nasheed-x/aether/hardware/aether.png

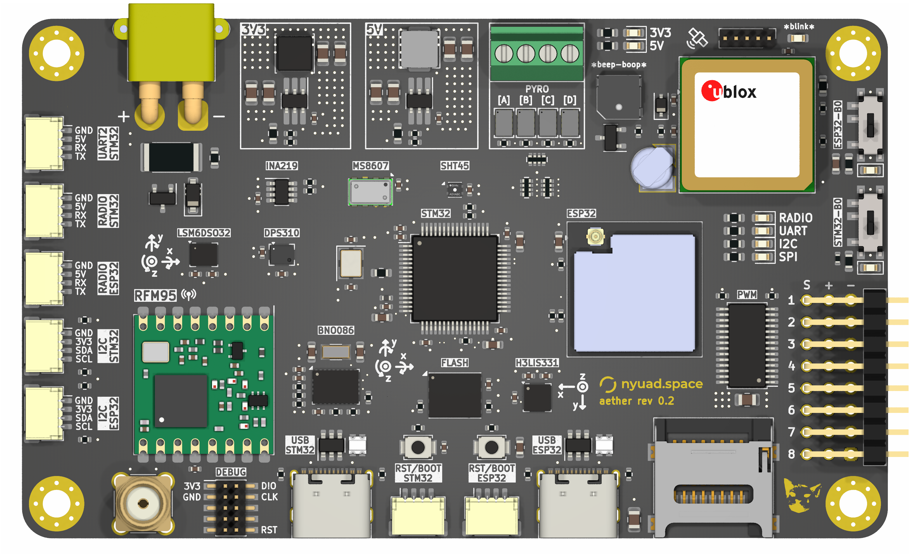
hardware/aether.png
