nasheed-x/aether/hardware/symbols/3x8 Male Pin Header Angle.STEP

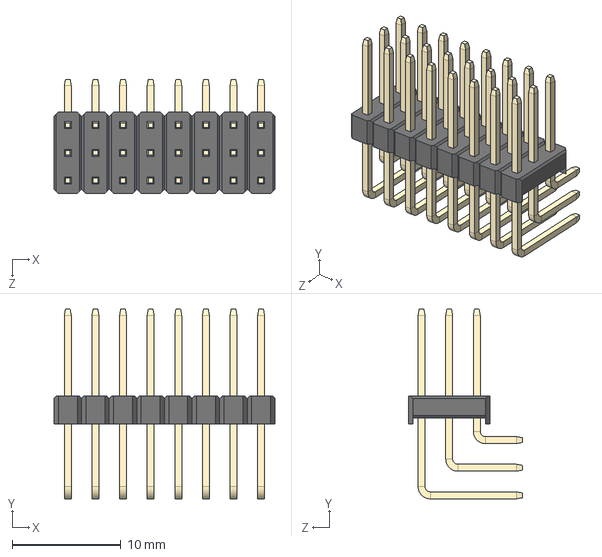
[picture p3: CAD file, 2025-07-07]
hardware/symbols/3x8 Male Pin Header Angle.STEP
20.3 x 17.4 x 10.5 mm
