nasheed-x/aether/hardware/symbols/5-1814832-1/5-1814832-1.step

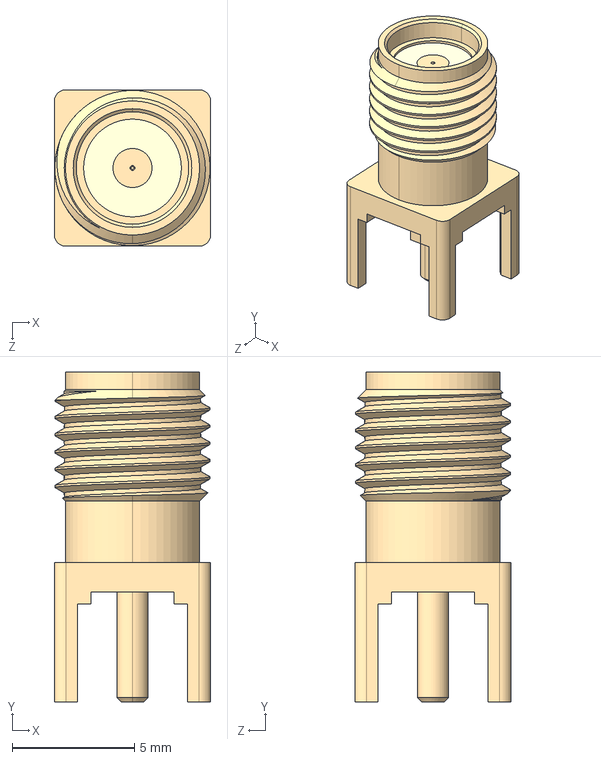
[picture p4: CAD file, 2025-07-07]
hardware/symbols/5-1814832-1/5-1814832-1.step
6.40 x 13.5 x 6.40 mm
