nasheed-x/aether/hardware/symbols/CSS-0575B-SMT/CSS-0575B-SMT.step

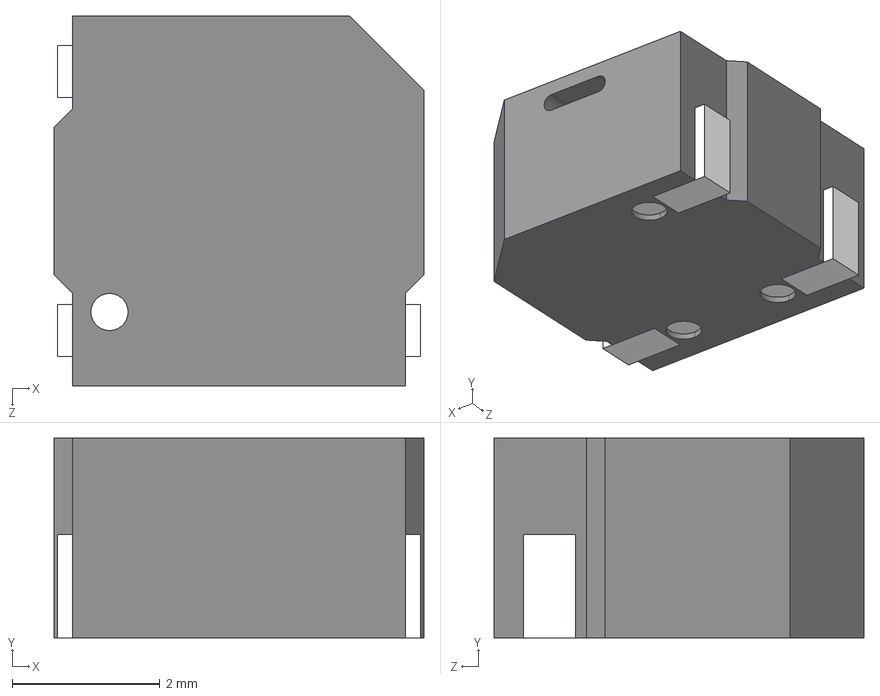
[picture p5: CAD file, 2025-07-07]
hardware/symbols/CSS-0575B-SMT/CSS-0575B-SMT.step
5.00 x 2.70 x 5.00 mm
