nasheed-x/aether/hardware/symbols/DPS310/DPS310.step

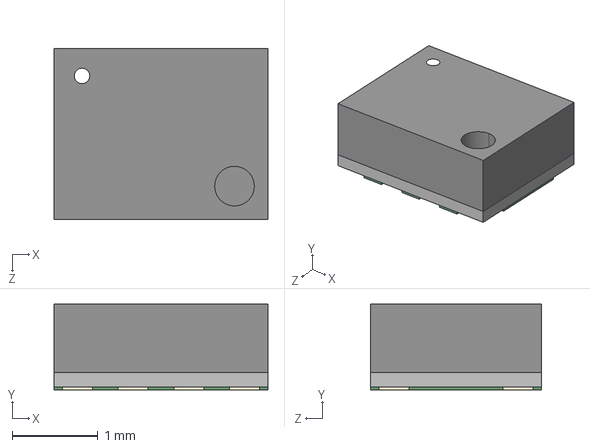
[picture p6: CAD file, 2025-07-07]
hardware/symbols/DPS310/DPS310.step
2.50 x 1.00 x 2.00 mm
