nasheed-x/aether/hardware/symbols/ESP32-S3-MINI-1U-N8/ESP32-S3-MINI-1U-N8.step

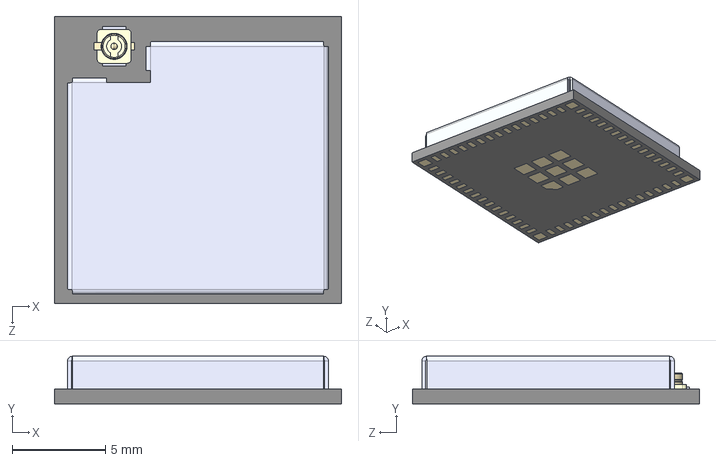
[picture p7: CAD file, 2025-07-07]
hardware/symbols/ESP32-S3-MINI-1U-N8/ESP32-S3-MINI-1U-N8.step
15.4 x 2.55 x 15.4 mm
ESP32-S3-MINI-1U-N8_ESP32-C3-MINI-1-N4
antenna jack
