nasheed-x/aether/hardware/symbols/ML414H_IV01E/ML414H_IV01E.step

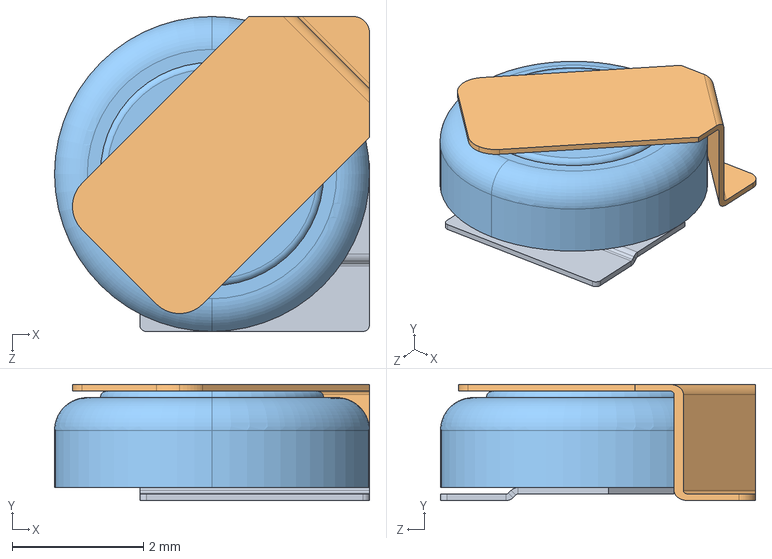
[picture p8: CAD file, 2025-07-07]
hardware/symbols/ML414H_IV01E/ML414H_IV01E.step
4.80 x 1.77 x 4.80 mm
