nasheed-x/aether/hardware/symbols/MS8607-02BA01/3D_PCB1_2025-03-28 parts - DFN-8_L5.0-W3.0-P1.25-BL-BR~DFN-8_L5.0-W3.0-P1.25-BL-BR~tLj9.step

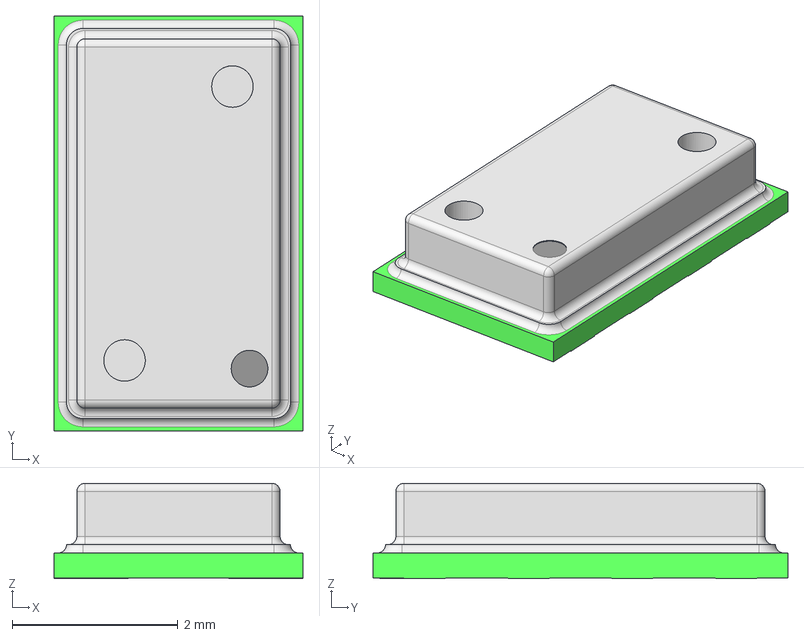
[picture p9: CAD file, 2025-07-07]
hardware/symbols/MS8607-02BA01/3D_PCB1_2025-03-28 parts - DFN-8_L5.0-W3.0-P1.25-BL-BR~DFN-8_L5.0-W3.0-P1.25-BL-BR~tLj9.step
3.00 x 5.00 x 1.15 mm
