nasheed-x/aether/hardware/symbols/SHT45-AD1B-R2/SHT45-AD1B-R2.step

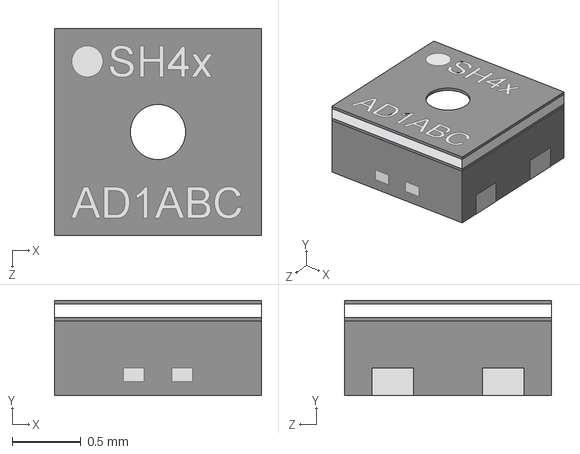
[picture p10: CAD file, 2025-07-07]
hardware/symbols/SHT45-AD1B-R2/SHT45-AD1B-R2.step
1.50 x 0.691 x 1.50 mm
