nasheed-x/aether/hardware/symbols/SI5442DU_T1_GE3/POWERPAK-CHIPFET-8_L3.0-W1.9-P0.65.step

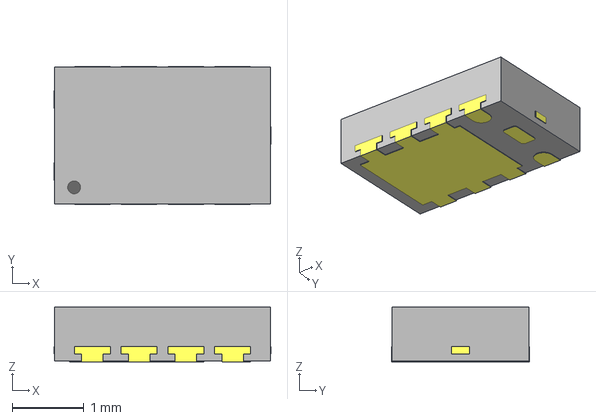
[picture p11: CAD file, 2025-07-07]
hardware/symbols/SI5442DU_T1_GE3/POWERPAK-CHIPFET-8_L3.0-W1.9-P0.65.step
3.02 x 1.92 x 0.76 mm
