nasheed-x/aether/hardware/symbols/TSW-108-08-T-T-RA/TSW-108-08-T-T-RA.step

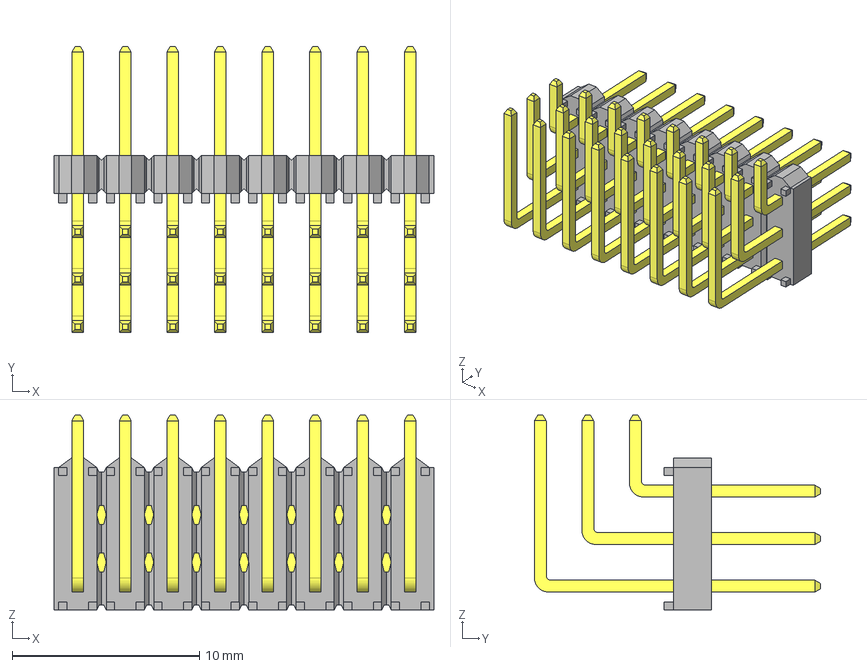
[picture p12: CAD file, 2025-07-07]
hardware/symbols/TSW-108-08-T-T-RA/TSW-108-08-T-T-RA.step
20.3 x 15.3 x 10.4 mm
TSW-108-08-T-T-RA_body
T-1S6-08-TSW-1-08-8-RA-T
