nasheed-x/aether/hardware/aether.kicad_pcb

## KiCad design hardware/aether.kicad_pcb (2025-07-12)

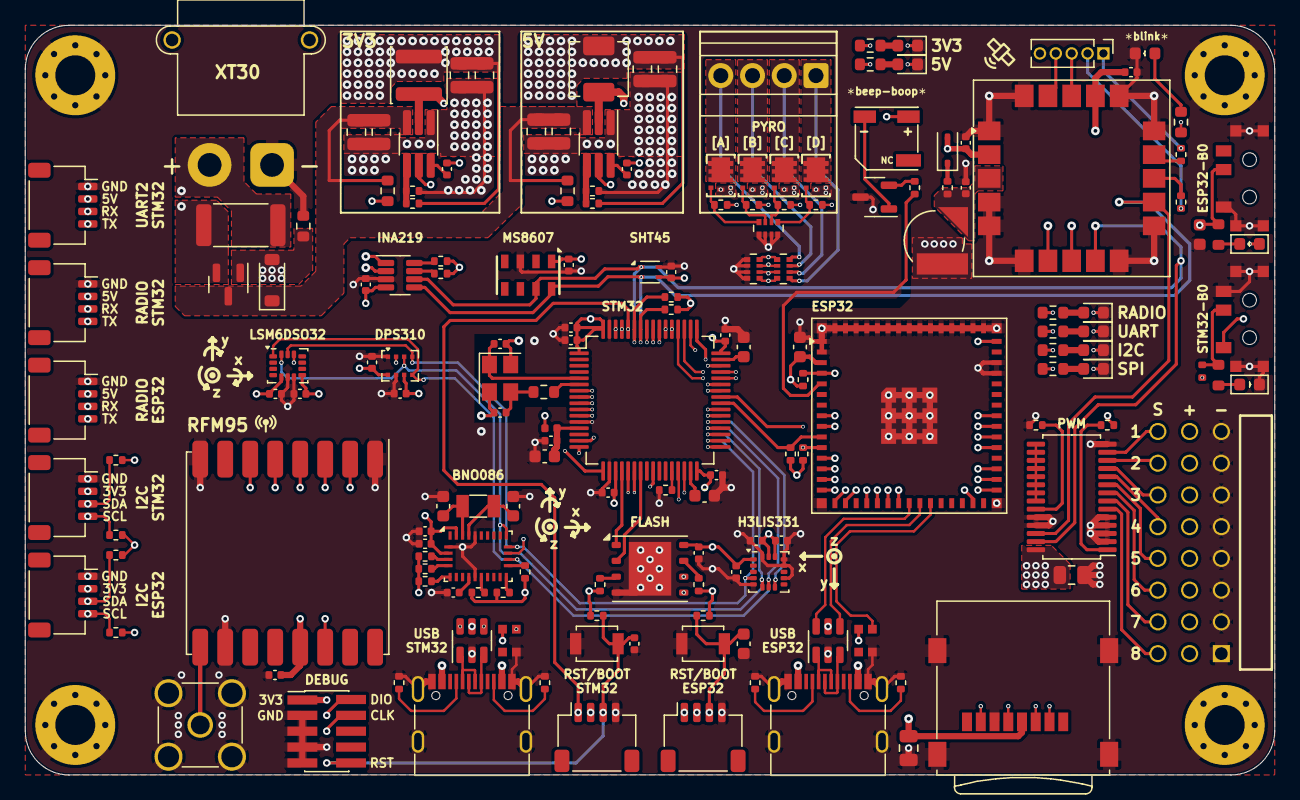
[picture p19: board hardware/aether.kicad_pcb from above]

Board: 6 copper layers, 100.0 x 60.0 mm, 173 parts (0 on the bottom side), 147 nets.

Parts:
ANT1: Antenna_Shield; SMA_Amphenol_901-144_Vertical
BT1: Battery_Cell; SEIKO_ML414H_IV01E
BUZ1: FST-5030; BUZ-SMD_FST-5030
C1, C2: 2.2uF; C_0603_1608Metric
C3, C4, C5, C6, C7, C10, C12, C16, C17, C18, C19, C20, C21, C22, C23, C24, C26, C27, C28, C30, C31, C34, C39, C42, C43, C46, C47: 100nF; C_0402_1005Metric
C8, C9: 10pF; C_0402_1005Metric
C11, C13, C14: 1uF; C_0603_1608Metric
C15: 10uF; C_0603_1608Metric
C25, C29, C32, C33, C37, C38: 10uF; C_0805_2012Metric
C35, C36, C40, C41: 22uF; C_0805_2012Metric
C44, C45: 22pF; C_0603_1608Metric
D1: PULSE_LED; LED_0603_1608Metric
D2: 0.5A/40V/420mV; D_SOD-323
D3: FUXINSEMI DSK34; D_SOD-123
D4, D5, D6, D7: LED; LED_0603_1608Metric
ESP32-S3: ESP32-S3-MINI-1U; ESP32-S2-MINI-1U
ESPBOOT0: BLUE; LED_0603_1608Metric
ESPRGB1: WS2812B-2020; LED_WS2812B-2020_PLCC4_2.0x2.0mm
ESP_B0: SS-3292S-L2-B; SW-SMD_SS-3292S-L2-B
ESP_RST1: SW_Push; SW_SPST_B3U-1000P
FB1: 600Ω; L_0402_1005Metric
G2: LOGO
GPS_IO1: Conn_01x05_Pin; PinHeader_1x05_P1.27mm_Vertical
H1, H2, H3, H4: MountingHole_Pad; MountingHole_3.2mm_M3_Pad_Via
HSE1: 25MHz; Crystal_SMD_Abracon_ABM8G-4Pin_3.2x2.5mm
I2C-ESP1, I2C-STM1: SM04B-SRSS-TB(LF)(SN); JST_SH_SM04B-SRSS-TB_1x04-1MP_P1.00mm_Horizontal
INA219: INA219AxDCN; SOT-23-8
L1: 4.7uH; L_Changjiang_FXL0420
L2: 3.3uH; L_Changjiang_FNR4030S
LED1, LED2: R; LED_0603_1608Metric
PCA9685: PCA9685PW; TSSOP-28_4.4x9.7mm_P0.65mm
PWM1: 24-Pin 8x3 Male Header - Angle; SAMTEC_TSW-108-08-T-T-RA
PYRO1: Screw_Terminal_01x04; TerminalBlock_Xinya_XY308-2.54-4P_1x04_P2.54mm_Horizontal
Q1: S8050_C2146; SOT-23-3
Q6: AO3401A; SOT-23
R1, R5, R13, R25, R26, R27, R28, R29, R30, R31, R32, R37, R40, R42, R43, R58, R59, R60, R61: 10k; R_0402_1005Metric
R2: 1k; R_0402_1005Metric
R3: 620; R_0603_1608Metric
R4: 2.2K; R_0603_1608Metric
R6, R7, R16, R19, R20, R55: 5.1k; R_0402_1005Metric
R8, R9, R10, R11: 330; R_0402_1005Metric
R12, R23, R45, R46, R47, R48, R49, R50: 2.2k; R_0603_1608Metric
R14, R15, R33, R34, R56, R57: 4.7k; R_0402_1005Metric
R21, R22: 470; R_0402_1005Metric
R24: 3.3k; R_0402_1005Metric
R35, R38, R41: 100k; R_0603_1608Metric
R36: 54.9k; R_0402_1005Metric
R39: 33.2k; R_0402_1005Metric
R44: 0.01; R_2512_6332Metric
RFM95: RFM95W-915S2; HOPERF_RFM9XW_SMD
RN1: 10k; R_Array_Convex_4x0402
RN2: 47k; R_Array_Convex_4x0402
RN3: 270k; R_Array_Convex_4x0402
RST-BOOT-ESP32: SM04B-SRSS-TB(LF)(SN); JST_SH_SM04B-SRSS-TB_1x04-1MP_P1.00mm_Horizontal
RST-BOOT-STM32: SM04B-SRSS-TB(LF)(SN); JST_SH_SM04B-SRSS-TB_1x04-1MP_P1.00mm_Horizontal
SAM-M10Q1: SAM-M10Q-00B; ublox_SAM-M8Q
SD1: Micro_SD_Card; microSD_HC_Wuerth_693072010801
STM32F4: STM32F405RGTx; LQFP-64_10x10mm_P0.5mm
STMBOOT0: BLUE; LED_0603_1608Metric
STMRGB1: WS2812B-2020; LED_WS2812B-2020_PLCC4_2.0x2.0mm
STM_B0: SS-3292S-L2-B; SW-SMD_SS-3292S-L2-B
STM_RST1: SW_Push; SW_SPST_B3U-1000P
SWD1: Conn_02x05_Odd_Even; PinHeader_2x05_P1.27mm_Vertical_SMD
U1, U2: USBLC6-2SC6; SOT-23-6
U3, U7, U12, U14: SI5448DU-T1-GE3; SON_8DU-T1-GE3_VIS
U4: DPS310; XDCR_DPS310
U5: H3LIS331DL; LGA-16_3x3mm_P0.5mm_LayoutBorder3x5y
U6: LSM6DSO32TR; LGA-14_3x2.5mm_P0.5mm_LayoutBorder3x4y
U8: MS860702BA01-50; MS8607-02BA01
U9: SHT45-AD1B-R2; Sensirion_DFN-4_1.5x1.5mm_P0.8mm_SHT4x_NoCentralPad
U10, U11: TPS562201DDCR; TSOT-23-6_HandSoldering
U13: BNO086; LGA-28_5.2x3.8mm_P0.5mm
U15: W25Q128JVP; WSON-8-1EP_6x5mm_P1.27mm_EP3.4x4.3mm
UART1-RFD-ESP1, UART1-RFD-STM1, UART2-STM1: SM04B-SRSS-TB(LF)(SN); JST_SH_SM04B-SRSS-TB_1x04-1MP_P1.00mm_Horizontal
USB_ESP32: USB_C_Receptacle_USB2.0; USB_C_Receptacle_G-Switch_GT-USB-7010ASV
USB_STM32: USB_C_Receptacle_USB2.0; USB_C_Receptacle_G-Switch_GT-USB-7010ASV
XT30: XT30PW-M; AMASS_XT30PW-M_1x02_P2.50mm_Horizontal
Y1: 32.768kHz; Crystal_SMD_3215-2Pin_3.2x1.5mm

Connections:
3.3V: BUZ1.1 (+), C3.1, C4.1, C5.1, C6.1, C7.1, C15.1, C16.1, C17.1, C18.1, C19.1, C20.1, C21.1, C22.1, C24.1, C25.1, C26.1, C27.1, C28.1, C29.1, C30.1, C31.1, C40.1, C41.1, C42.1, C46.1, C47.1, D2.2 (A), ESP32-S3.3 (3V3), ESPBOOT0.2 (A), ESPRGB1.4 (VDD), FB1.2, I2C-ESP1.2, I2C-STM1.2, INA219.4 (VS), L2.2, PCA9685.28 (VDD), R13.2, R14.2, R15.2, R16.2, R25.1, R26.1, R28.2, R29.2, R30.2, R31.2, R32.2, R33.2, R34.2, R39.1, R42.2, R43.2, R46.1, R55.2, R56.2, R57.2, R58.1, R59.1, R60.1, R61.2, RFM95.13 (3.3V), RST-BOOT-ESP32.2, RST-BOOT-STM32.2, SAM-M10Q1.2 (V_IO), SAM-M10Q1.17 (VCC), SD1.4 (VDD), STM32F4.1 (VBAT), STM32F4.19 (VDD), STM32F4.32 (VDD), STM32F4.48 (VDD), STM32F4.64 (VDD), STMRGB1.4 (VDD), STM_B0.1, SWD1.1, U4.6 (VDDIO), U4.8 (VDD), U5.1 (VDD_IO), U5.14 (VDD), U5.15 (VDD), U6.5 (VDDIO), U6.8 (VDD), U8.1 (VDD), U9.3 (VDD), U13.3 (VDD), U13.28 (VDDIO), U15.8 (VCC)
5V: C35.1, C36.1, L1.2, PWM1.02, PWM1.05, PWM1.08, PWM1.11, PWM1.14, PWM1.17, PWM1.20, PWM1.23, R36.1, R45.1, UART1-RFD-ESP1.2, UART1-RFD-STM1.2, UART2-STM1.2
BNO086_CS: STM32F4.39 (PC8), U13.18 (~H_CS)
BNO086_MISO: SD1.3 (CMD), STM32F4.35 (PB14), U4.3 (SDI), U5.6 (SDA/SDI/SDO), U6.14 (SDA), U13.20 (H_SDA/H_MISO/TX)
BNO086_MOSI: SD1.7 (DAT0), STM32F4.36 (PB15), U4.5 (SDO), U5.7 (SDO/SA0), U6.1 (SDO/SA0), U13.17 (SA0/H_MOSI)
BNO086_RST: R61.1, U13.11 (~RST)
BNO086_SCK: SD1.5 (CLK), STM32F4.34 (PB13), U4.4 (SCK), U5.4 (SCL/SPC), U6.13 (SCL), U13.19 (H_SCL/SCK/RX)
BUZZ_IN: ESP32-S3.5 (IO1), R2.2
CROSS_I2C: ESP32-S3.36 (IO40), R49.2
CROSS_SPI: ESP32-S3.35 (IO39), R48.2
CROSS_UART: ESP32-S3.37 (IO41), R50.2
DPS310_CSB: STM32F4.33 (PB12), U4.2 (~CSB)
ESP32-EN: C14.1, ESP32-S3.45 (EN), ESP_RST1.2, R16.1, RST-BOOT-ESP32.3
ESP32-GPIO0: C13.1, ESP32-S3.4 (IO0), ESP_B0.2, R12.1, R13.1, RST-BOOT-ESP32.1
ESP32-I2C1_SCL: ESP32-S3.9 (IO5), I2C-ESP1.4, R32.1
ESP32-I2C1_SDA: ESP32-S3.8 (IO4), I2C-ESP1.3, R31.1
ESP32-I2C2_SCL: ESP32-S3.11 (IO7), R15.1, STM32F4.41 (PA8)
ESP32-I2C2_SDA: ESP32-S3.10 (IO6), R14.1, STM32F4.40 (PC9)
ESP32-RGB_IN: ESP32-S3.25 (IO21), ESPRGB1.3 (DIN)
ESP32-RX1: ESP32-S3.22 (IO18), UART1-RFD-ESP1.3
ESP32-RX2: ESP32-S3.20 (IO16), STM32F4.51 (PC10)
ESP32-SPI1_CS0: ESP32-S3.14 (IO10), RFM95.5 (NSS)
ESP32-SPI1_MISO: ESP32-S3.17 (IO13), RFM95.2 (MISO)
ESP32-SPI1_MOSI: ESP32-S3.15 (IO11), RFM95.3 (MOSI)
ESP32-SPI1_SCK: ESP32-S3.16 (IO12), RFM95.4 (SCK)
ESP32-SPI2_CS0: ESP32-S3.29 (IO34), STM32F4.50 (PA15)
ESP32-SPI2_MISO: ESP32-S3.33 (IO37), STM32F4.56 (PB4)
ESP32-SPI2_MOSI: ESP32-S3.31 (IO35), STM32F4.57 (PB5)
ESP32-SPI2_SCK: ESP32-S3.32 (IO36), STM32F4.55 (PB3)
ESP32-TX1: ESP32-S3.21 (IO17), UART1-RFD-ESP1.4
ESP32-TX2: ESP32-S3.19 (IO15), STM32F4.52 (PC11)
ESP32-USB_D+: ESP32-S3.24 (USB_D+), U2.4 (I/O2)
ESP32-USB_D-: ESP32-S3.23 (USB_D-), U2.6 (I/O1)
F405_VDDA: C10.1, C11.1, FB1.1, STM32F4.13 (VDDA)
FLASH_CLK: STM32F4.21 (PA5), U15.6 (CLK)
FLASH_CS: STM32F4.20 (PA4), U15.1 (~CS)
FLASH_HOLD: R26.2, U15.7 (~HOLD/~RESET/IO_{3})
FLASH_SDI: STM32F4.22 (PA6), U15.5 (DI/IO_{0})
FLASH_SDO: STM32F4.23 (PA7), U15.2 (DO/IO_{1})
FLASH_WP: R25.2, U15.3 (~WP/IO_{2})
GND: ANT1.2 (Shield), BT1.2 (-), C1.2, C2.2, C3.2, C4.2, C5.2, C6.2, C7.2, C8.1, C9.2, C10.2, C11.2, C12.2, C13.2, C14.2, C15.2, C16.2, C17.2, C18.2, C19.2, C20.2, C21.2, C22.2, C23.2, C24.2, C25.2, C26.2, C27.2, C28.2, C29.2, C30.2, C31.2, C32.2, C33.2, C35.2, C36.2, C37.2, C38.2, C40.2, C41.2, C42.2, C43.2, C44.2, C45.2, C46.2, C47.2, D1.1 (K), D4.1 (K), D5.1 (K), D6.1 (K), D7.1 (K), ESP32-S3.1 (GND), ESP32-S3.2 (GND), ESP32-S3.42 (GND), ESP32-S3.43 (GND), ESP32-S3.46 (GND), ESP32-S3.47 (GND), ESP32-S3.48 (GND), ESP32-S3.49 (GND), ESP32-S3.50 (GND), ESP32-S3.51 (GND), ESP32-S3.52 (GND), ESP32-S3.53 (GND), ESP32-S3.54 (GND), ESP32-S3.55 (GND), ESP32-S3.56 (GND), ESP32-S3.57 (GND), ESP32-S3.58 (GND), ESP32-S3.59 (GND), ESP32-S3.60 (GND), ESP32-S3.61 (GND), ESP32-S3.62 (GND), ESP32-S3.63 (GND), ESP32-S3.64 (GND), ESP32-S3.65 (GND), ESPRGB1.2 (VSS), ESP_B0.1, ESP_B0.EH, ESP_RST1.1, H1.1, H2.1, H3.1, H4.1, HSE1.2, HSE1.4, I2C-ESP1.1, I2C-STM1.1, INA219.3 (GND), LED1.1 (K), LED2.1 (K), PCA9685.2 (A1), PCA9685.3 (A2), PCA9685.4 (A3), PCA9685.5 (A4), PCA9685.14 (VSS), PCA9685.24 (A5), PCA9685.25 (EXTCLK), PWM1.01, PWM1.04, PWM1.07, PWM1.10, PWM1.13, PWM1.16, PWM1.19, PWM1.22, Q1.3 (E), R1.1, R6.1, R7.2, R19.1, R20.2, R27.2, R37.2, R40.2, R41.2, RFM95.1 (GND), RFM95.8 (GND), RFM95.10 (GND), RN1.5 (R4.2), RN1.6 (R3.2), RN1.7 (R2.2), RN1.8 (R1.2), RN2.1 (R1.1), RN2.2 (R2.1), RN2.3 (R3.1), RN2.4 (R4.1), RST-BOOT-ESP32.4, RST-BOOT-STM32.4, SAM-M10Q1.1 (GND), SAM-M10Q1.4 (GND), SAM-M10Q1.5 (GND), SAM-M10Q1.6 (GND), SAM-M10Q1.10 (GND), SAM-M10Q1.11 (GND), SAM-M10Q1.15 (GND), SAM-M10Q1.16 (GND), SAM-M10Q1.20 (GND), SD1.6 (VSS), SD1.9 (SHIELD), STM32F4.12 (VSSA), STM32F4.18 (VSS), STM32F4.63 (VSS), STMBOOT0.1 (K), STMRGB1.2 (VSS), STM_B0.3, STM_B0.EH, STM_RST1.1, SWD1.3, SWD1.5, SWD1.7, SWD1.9, U1.2 (GND), U2.2 (GND), U3.5 (S), U3.9 (S), U4.1 (GND), U4.7 (GND), U5.5 (GND), U5.10 (GND), U5.12 (GND), U5.13 (GND), U5.16 (GND), U6.6 (GND), U6.7 (GND), U7.5 (S), U7.9 (S), U8.3 (GND), U9.4 (VSS), U10.1 (GND), U11.1 (GND), U12.5 (S), U12.9 (S), U13.2 (GND), U13.10 (CLKSEL0), U13.25 (GNDIO), U14.5 (S), U14.9 (S), U15.4 (GND), U15.9 (EP), UART1-RFD-ESP1.1, UART1-RFD-STM1.1, UART2-STM1.1, USB_ESP32.A1 (GND), USB_ESP32.A12 (GND), USB_ESP32.B1 (GND), USB_ESP32.B12 (GND), USB_ESP32.S1 (SHIELD), USB_STM32.A1 (GND), USB_STM32.A12 (GND), USB_STM32.B1 (GND), USB_STM32.B12 (GND), USB_STM32.S1 (SHIELD), XT30.1 (N)
GPS_INT: GPS_IO1.4, SAM-M10Q1.19 (EXTINT)
GPS_RST: GPS_IO1.3, SAM-M10Q1.18 (~RESET)
GPS_RX: GPS_IO1.1, R22.2
GPS_SAFE: GPS_IO1.5, SAM-M10Q1.8 (~SAFEBOOT)
GPS_SCL: INA219.5 (SCL), PCA9685.26 (SCL), R34.1, SAM-M10Q1.12 (SCL), STM32F4.58 (PB6), U8.8 (SCL), U9.2 (SCL)
GPS_SDA: INA219.6 (SDA), PCA9685.27 (SDA), R33.1, SAM-M10Q1.9 (SDA), STM32F4.59 (PB7), U8.7 (SDA), U9.1 (SDA)
GPS_TX: GPS_IO1.2, R21.1
GPS_VBCKP: BT1.1 (+), C23.1, R24.1, SAM-M10Q1.3 (V_BCKP)
H3LIS331DL_CS: STM32F4.37 (PC6), U5.8 (CS)
INA219_IN+: INA219.1 (IN+), R44.1, XT30.2
INA219_IN-: INA219.2 (IN-), Q6.2 (D), R44.2
LSM6DSO32TR_CS: STM32F4.25 (PC5), U6.12 (CS)
unnamed: C9.1, HSE1.3, R3.2
unnamed: D1.2 (A), R23.1
unnamed: D2.1 (K), R24.2
unnamed: D4.2 (A), R47.1
unnamed: D5.2 (A), R48.1
unnamed: D6.2 (A), R49.1
unnamed: D7.2 (A), R50.1
unnamed: ESPBOOT0.1 (K), R12.2
unnamed: INA219.7 (A0), R43.1
unnamed: INA219.8 (A1), R42.1
unnamed: LED1.2 (A), R45.2
unnamed: LED2.2 (A), R46.2
unnamed: PCA9685.1 (A0), R28.1
unnamed: PCA9685.23 (~OE), R27.1
unnamed: Q1.2 (B), R2.1
unnamed: BUZ1.2, Q1.1 (C)
unnamed: R4.2, R5.2, STM_B0.2
unnamed: R11.1, RN1.1 (R1.1), U3.4 (G)
unnamed: R10.1, RN1.2 (R2.1), U7.4 (G)
unnamed: R9.1, RN1.3 (R3.1), U12.4 (G)
unnamed: R8.1, RN1.4 (R4.1), U14.4 (G)
unnamed: R22.1, SAM-M10Q1.14 (RXD)
unnamed: R21.2, SAM-M10Q1.13 (TXD)
unnamed: R1.2, STM32F4.28 (PB2)
unnamed: C1.1, STM32F4.31 (VCAP_1)
unnamed: C2.1, STM32F4.47 (VCAP_2)
unnamed: R4.1, STMBOOT0.2 (A)
unnamed: R35.2, U10.5 (EN)
unnamed: C34.2, L1.1, U10.2 (SW)
unnamed: C34.1, U10.6 (VBST)
unnamed: R36.2, R37.1, U10.4 (VFB)
unnamed: R38.2, U11.5 (EN)
unnamed: C39.2, L2.1, U11.2 (SW)
unnamed: C39.1, U11.6 (VBST)
unnamed: R39.2, R40.1, U11.4 (VFB)
unnamed: C43.1, U13.9 (CAP)
unnamed: R56.1, U13.15 (ENV_SCL)
unnamed: R57.1, U13.16 (ENV_SDA)
unnamed: R59.2, U13.6 (PS0/WAKE)
unnamed: R58.2, U13.5 (PS1)
unnamed: C44.1, U13.27 (XIN32), Y1.2
unnamed: C45.1, U13.26 (XOUT32/CLKSEL1), Y1.1
unnamed: R60.2, U13.4 (~BOOT)
unnamed: R19.2, USB_ESP32.A5 (CC1)
unnamed: R20.1, USB_ESP32.B5 (CC2)
unnamed: R6.2, USB_STM32.A5 (CC1)
unnamed: R7.1, USB_STM32.B5 (CC2)
PULSE: R23.2, SAM-M10Q1.7 (TIMEPULSE)
PWM0: PCA9685.13 (LED7), PWM1.24
PWM1: PCA9685.12 (LED6), PWM1.21
PWM2: PCA9685.11 (LED5), PWM1.18
PWM3: PCA9685.10 (LED4), PWM1.15
PWM4: PCA9685.9 (LED3), PWM1.12
PWM5: PCA9685.8 (LED2), PWM1.09
PWM6: PCA9685.7 (LED1), PWM1.06
PWM7: PCA9685.6 (LED0), PWM1.03
PYRO-TERM_A: PYRO1.4, RN3.8 (R1.2), U14.1 (D)
PYRO-TERM_B: PYRO1.3, RN3.7 (R2.2), U12.1 (D)
PYRO-TERM_C: PYRO1.2, RN3.6 (R3.2), U7.1 (D)
PYRO-TERM_D: PYRO1.1, RN3.5 (R4.2), U3.1 (D)
PYRO_A: R8.2, STM32F4.62 (PB9)
PYRO_B: R9.2, STM32F4.61 (PB8)
PYRO_C: R10.2, STM32F4.54 (PD2)
PYRO_D: R11.2, STM32F4.53 (PC12)
RFD_900: ESP32-S3.38 (IO42), R47.2
RFM95W_ANT: ANT1.1 (A), RFM95.9 (ANT)
RFM95W_DI0: ESP32-S3.13 (IO9), RFM95.14 (DIO0)
RFM95W_RST: ESP32-S3.12 (IO8), RFM95.6 (RESET)
SD_CS: SD1.2 (DAT3/CD), STM32F4.38 (PC7)
STM32-BOOT0: R5.1, RST-BOOT-STM32.1, STM32F4.60 (BOOT0)
STM32-HSE_IN: C8.2, HSE1.1, STM32F4.5 (PH0)
STM32-HSE_OUT: R3.1, STM32F4.6 (PH1)
STM32-I2C2_SCL: I2C-STM1.4, R30.1, STM32F4.29 (PB10)
STM32-I2C2_SDA: I2C-STM1.3, R29.1, STM32F4.30 (PB11)
STM32-NRST: C12.1, R55.1, RST-BOOT-STM32.3, STM32F4.7 (NRST), STM_RST1.2, SWD1.10
STM32-RGB_IN: STM32F4.15 (PA1), STMRGB1.3 (DIN)
STM32-SWCLK: STM32F4.49 (PA14), SWD1.4
STM32-SWDIO: STM32F4.46 (PA13), SWD1.2
STM32-UART1_RX: STM32F4.43 (PA10), UART1-RFD-STM1.3
STM32-UART1_TX: STM32F4.42 (PA9), UART1-RFD-STM1.4
STM32-UART2_RX: STM32F4.17 (PA3), UART2-STM1.3
STM32-UART2_TX: STM32F4.16 (PA2), UART2-STM1.4
STM32_USB_D+: STM32F4.45 (PA12), U1.4 (I/O2)
STM32_USB_D-: STM32F4.44 (PA11), U1.6 (I/O1)
USB1_D+: U1.3 (I/O2), USB_STM32.A6 (D+), USB_STM32.B6 (D+)
USB1_D-: U1.1 (I/O1), USB_STM32.A7 (D-), USB_STM32.B7 (D-)
USB2_D+: U2.3 (I/O2), USB_ESP32.A6 (D+), USB_ESP32.B6 (D+)
USB2_D-: U2.1 (I/O1), USB_ESP32.A7 (D-), USB_ESP32.B7 (D-)
V-TERM_A: RN2.8 (R1.2), RN3.1 (R1.1), STM32F4.8 (PC0)
V-TERM_B: RN2.7 (R2.2), RN3.2 (R2.1), STM32F4.9 (PC1)
V-TERM_C: RN2.6 (R3.2), RN3.3 (R3.1), STM32F4.10 (PC2)
V-TERM_D: RN2.5 (R4.2), RN3.4 (R4.1), STM32F4.11 (PC3)
VBUS: D3.2 (A), Q6.1 (G), R41.1, U1.5 (VBUS), U2.5 (VBUS), USB_ESP32.A4 (VBUS), USB_ESP32.A9 (VBUS), USB_ESP32.B4 (VBUS), USB_ESP32.B9 (VBUS), USB_STM32.A4 (VBUS), USB_STM32.A9 (VBUS), USB_STM32.B4 (VBUS), USB_STM32.B9 (VBUS)
VIN: C32.1, C33.1, C37.1, C38.1, D3.1 (K), Q6.3 (S), R35.1, R38.1, U10.3 (VIN), U11.3 (VIN)
