nasheed-x/aether/aether.kicad_pcb

## KiCad design aether.kicad_pcb (2024-05-27)

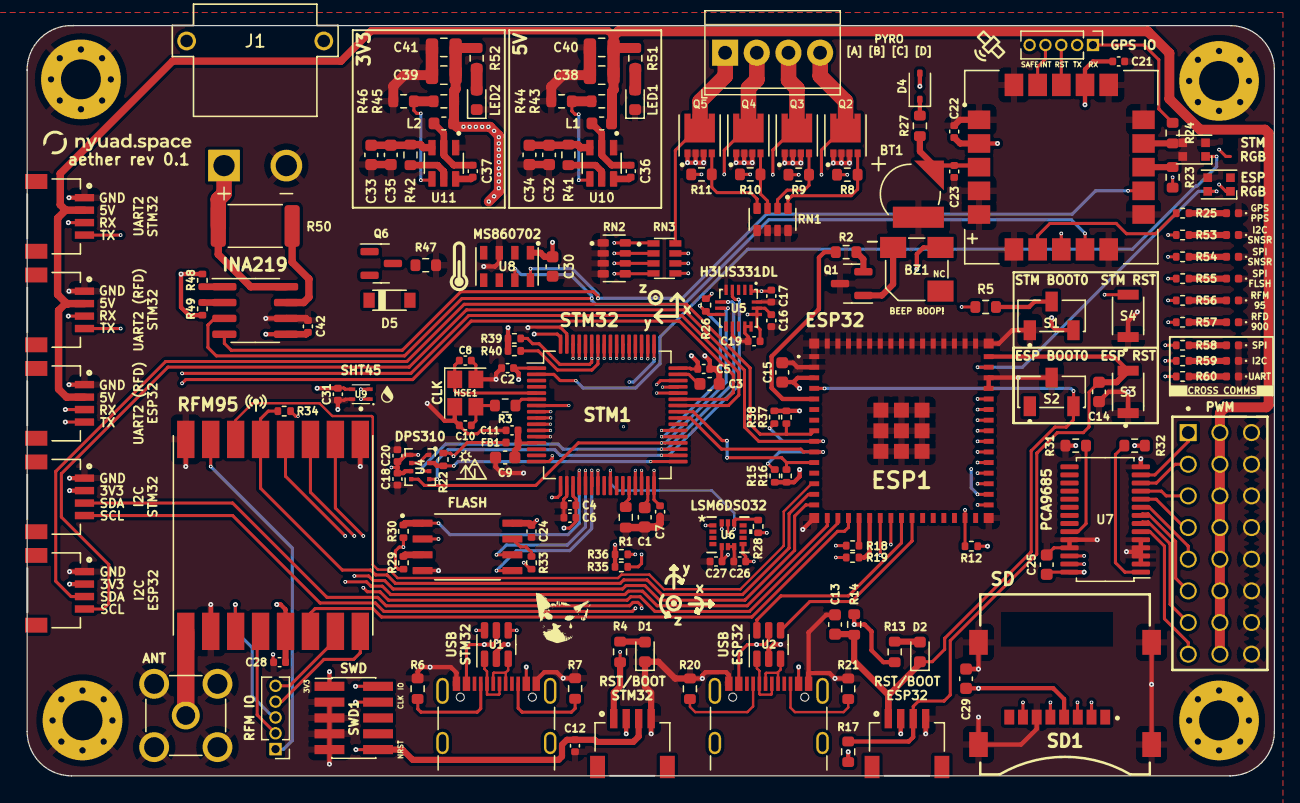
[picture p20: board aether.kicad_pcb from above]

Board: 4 copper layers, 100.1 x 60.2 mm, 171 parts (0 on the bottom side), 152 nets.

Parts:
ANT1: 5-1814832-1; TE_5-1814832-1
BT1: Battery_Cell; SEIKO_ML414H_IV01E
BZ1: CSS-0575A-SMT; CUI_CSS-0575A-SMT
C1, C3: 2.2uF; C_0603_1608Metric
C2, C4, C5, C6, C7, C11, C12, C16, C17, C18, C19, C20, C21, C22, C23, C26, C27, C28, C31, C36, C37, C42: 100nF; C_0402_1005Metric
C8, C10: 10pF; C_0402_1005Metric
C9, C13, C14: 1uF; C_0603_1608Metric
C15, C25, C29, C32, C33, C34, C35: 10uF; C_0603_1608Metric
C24: 10uF; C_0402_1005Metric
C30: 220nF; C_0603_1608Metric
C38, C39, C40, C41: 22uF; C_0805_2012Metric
D1: LED; LED_0603_1608Metric
D2: G; LED_0603_1608Metric
D3, D6, D7, D8, D9, D10, D11, D12, D13: LED; LED_0402_1005Metric
D4: 0.5A/40V/420mV; D_SOD-323
D5: B5819W-TP; SOD3716X135N
ESP1: ESP32-S3-MINI-1U-N8; ESP32S3MINI1UN8
FB1: 600Ω; L_0402_1005Metric
HSE1: 25MHz; Crystal_SMD_Abracon_ABM8G-4Pin_3.2x2.5mm
I2C-ESP1, I2C-STM1: SM04B-SRSS-TB(LF)(SN); JST_SM04B-SRSS-TB(LF)(SN)
J1: XT30PW-M; AMASS_XT30PW-M
J2: Screw_Terminal_01x04; TerminalBlock_TE_282834-4_1x04_P2.54mm_Horizontal
L1, L2: 3.9uH; L_0603_1608Metric
LED1, LED2: R; LED_0603_1608Metric
PWM1: TSW-108-07-G-T; SAMTEC_TSW-108-07-G-T
Q1: NPN; SOT-23
Q2, Q3, Q4, Q5: CSD17575Q3; TRANS_CSD17308Q3
Q6: PNP; SOT-23
R1, R5, R14, R17, R31, R32, R44, R46: 10k; R_0603_1608Metric
R2: 1k; R_0603_1608Metric
R3: 620; R_0603_1608Metric
R4, R13: R; R_0603_1608Metric
R6, R7, R20, R21: 5.1k; R_0603_1608Metric
R8, R9, R10, R11: 330; R_0603_1608Metric
R12, R22, R26, R28, R29, R30, R33, R34, R35, R36, R37, R38, R48, R49: 10k; R_0402_1005Metric
R15, R16, R39, R40: 4.7k; R_0402_1005Metric
R18, R19: 10; R_0402_1005Metric
R23, R24: 470; R_0603_1608Metric
R25, R53, R54, R55, R56, R57, R58, R59, R60: 2.2k; R_0402_1005Metric
R27: 3.3k; R_0603_1608Metric
R41, R42, R47: 100k; R_0603_1608Metric
R43: 54.9k; R_0603_1608Metric
R45: 33.2k; R_0603_1608Metric
R50: 0.01; R_2512_6332Metric
R51: 560; R_0603_1608Metric
R52: 240; R_0603_1608Metric
RFM1: RFM95W-915S2; XCVR_RFM95W-915S2
RFM2, RFM3: Conn_01x05_Pin; PinHeader_1x05_P1.27mm_Vertical
RGB1, RGB2: WS2812B-2020; LED_WS2812B-2020_PLCC4_2.0x2.0mm
RN1: 10k; RESCAXE80P320X160X70-8N
RN2: 47k; RESCAXE80P320X160X70-8N
RN3: 270k; RESCAV80P320X160X70-8N
RST-BOOT-ESP1: SM04B-SRSS-TB(LF)(SN); JST_SM04B-SRSS-TB(LF)(SN)
RST-BOOT-STM1: SM04B-SRSS-TB(LF)(SN); JST_SM04B-SRSS-TB(LF)(SN)
S1, S2: CJS-1200TA; SW_CJS-1200TA
S3, S4: B3U-1000P; SW_B3U-1000P
SD1: MEM2067-02-180-00-A_REVB; GCT_MEM2067-02-180-00-A_REVB
STM1: STM32F405RGTx; LQFP-64_10x10mm_P0.5mm
SWD1: Conn_02x05_Odd_Even; PinHeader_2x05_P1.27mm_Vertical_SMD
U1, U2: USBLC6-2SC6; SOT-23-6
U3: SAM-M10Q-00B; XCVR_SAM-M10Q-00B
U4: DPS310; XDCR_DPS310
U5: H3LIS331DL; QFN300X300X100-16N
U6: LSM6DSO32TR; LGA-14L_2P5X3X0P83_STM
U7: PCA9685PW; TSSOP-28_4.4x9.7mm_P0.65mm
U8: MS860702BA01-50; TE_MS860702BA01-50
U9: SHT45-AD1B-R2; SHT4X
U10, U11: TPS562201DDCR; SOT95P280X110-6N
U12: INA219AxD; SOIC-8_3.9x4.9mm_P1.27mm
UART1-RFD-ESP1, UART1-RFD-STM1, UART2-STM1: SM04B-SRSS-TB(LF)(SN); JST_SM04B-SRSS-TB(LF)(SN)
USB1, USB2: USB_C_Receptacle_USB2.0; USB_C_Receptacle_GCT_USB4105-xx-A_16P_TopMnt_Horizontal
W25Q1: W25Q128JVSIQ; SOIC127P790X216-8N

Connections:
3.3V: BZ1.1, C2.1, C4.1, C5.1, C6.1, C7.1, C15.1, C16.1, C17.1, C18.1, C19.1, C20.1, C21.1, C22.1, C24.1, C25.1, C26.1, C27.1, C28.1, C29.1, C30.1, C31.1, C39.1, C41.1, C42.1, D4.2 (A), ESP1.3 (3V3), FB1.2, I2C-ESP1.2, I2C-STM1.2, L2.2, R12.1, R13.2, R14.2, R15.2, R16.2, R17.2, R22.1, R26.1, R28.1, R29.1, R30.1, R32.2, R33.1, R34.1, R35.2, R36.2, R37.2, R38.2, R39.2, R40.2, R45.1, R48.2, R49.2, R52.1, RFM1.13 (3.3V), RGB1.1 (VDD), RGB2.1 (VDD), RST-BOOT-ESP1.2, RST-BOOT-STM1.2, S1.3, SD1.4 (VDD), STM1.1 (VBAT), STM1.19 (VDD), STM1.32 (VDD), STM1.48 (VDD), STM1.64 (VDD), SWD1.1, U3.2 (V_IO), U3.17 (VCC), U4.6 (VDDIO), U4.8 (VDD), U5.1 (VDD_IO), U5.14 (VDD), U5.15 (VDD), U6.5 (VDDIO), U6.8 (VDD), U7.28 (VDD), U8.1 (VDD), U9.3 (VDD), U12.5 (VS), W25Q1.8 (VCC)
5V: C38.1, C40.1, L1.2, PWM1.02, PWM1.05, PWM1.08, PWM1.11, PWM1.14, PWM1.17, PWM1.20, PWM1.23, R43.1, R51.1, UART1-RFD-ESP1.2, UART1-RFD-STM1.2, UART2-STM1.2
BUZZ_IN: ESP1.5 (IO1), R2.2
CROSS_I2C: ESP1.35 (IO39), R59.2
CROSS_SPI: ESP1.36 (IO40), R58.2
CROSS_UART: ESP1.34 (IO38), R60.2
DPS310_CSB: R22.2, STM1.33 (PB12), U4.2 (~CSB)
DPS310_SCK: SD1.5 (CLK), STM1.34 (PB13), U4.4 (SCK), U5.4 (SCL/SPC), U6.13 (SCL)
DPS310_SDI/SDA: SD1.3 (CMD), STM1.35 (PB14), U4.3 (SDI), U5.6 (SDA/SDI/SDO), U6.14 (SDA)
DPS310_SDO: SD1.7 (DAT0), STM1.36 (PB15), U4.5 (SDO), U5.7 (SDO/SA0), U6.1 (SDO/SA0)
ESP32-EN: C14.1, ESP1.45 (EN), R17.1, RST-BOOT-ESP1.3, S3.2
ESP32-GPIO0: C13.1, D2.1 (K), ESP1.4 (IO0), R14.1, RST-BOOT-ESP1.1, S2.3
ESP32-I2C1_SCL: ESP1.9 (IO5), I2C-ESP1.4, R38.1
ESP32-I2C1_SDA: ESP1.8 (IO4), I2C-ESP1.3, R37.1
ESP32-I2C2_SCL: ESP1.11 (IO7), R16.1, STM1.41 (PA8)
ESP32-I2C2_SDA: ESP1.10 (IO6), R15.1, STM1.40 (PC9)
ESP32-RGB_IN: ESP1.44 (IO46), RGB2.4 (DIN)
ESP32-RX1: ESP1.22 (IO18), UART1-RFD-ESP1.3
ESP32-RX2: ESP1.20 (IO16), R19.2
ESP32-SPI1_CS0: ESP1.14 (IO10), R34.2, RFM1.5 (NSS)
ESP32-SPI1_MISO: ESP1.17 (IO13), RFM1.2 (MISO)
ESP32-SPI1_MOSI: ESP1.15 (IO11), RFM1.3 (MOSI)
ESP32-SPI1_SCK: ESP1.16 (IO12), RFM1.4 (SCK)
ESP32-SPI2_CS0: ESP1.29 (IO34), R12.2, STM1.50 (PA15)
ESP32-SPI2_MISO: ESP1.33 (IO37), STM1.56 (PB4)
ESP32-SPI2_MOSI: ESP1.31 (IO35), STM1.57 (PB5)
ESP32-SPI2_SCK: ESP1.32 (IO36), STM1.55 (PB3)
ESP32-TX1: ESP1.21 (IO17), UART1-RFD-ESP1.4
ESP32-TX2: ESP1.19 (IO15), R18.2
ESP32-USB_D+: ESP1.24 (IO20), U2.4 (I/O2)
ESP32-USB_D-: ESP1.23 (IO19), U2.6 (I/O1)
F405_VDDA: C9.1, C11.1, FB1.1, STM1.13 (VDDA)
FLASH_CLK: STM1.21 (PA5), W25Q1.6 (CLK)
FLASH_CS: R30.2, STM1.20 (PA4), W25Q1.1 (/CS)
FLASH_HOLD: R33.2, W25Q1.7 (/HOLD/RESET(IO3))
FLASH_SDI: STM1.22 (PA6), W25Q1.5 (DI(IO0))
FLASH_SDO: STM1.23 (PA7), W25Q1.2 (DO(IO1))
FLASH_WP: R29.2, W25Q1.3 (/WP(IO2))
GND: ANT1.2, ANT1.3 (2), ANT1.4 (2), ANT1.5 (2), BT1.2 (-), C1.2, C2.2, C3.2, C4.2, C5.2, C6.2, C7.2, C8.1, C9.2, C10.2, C11.2, C12.2, C13.2, C14.2, C15.2, C16.2, C17.2, C18.2, C19.2, C20.2, C21.2, C22.2, C23.2, C24.2, C25.2, C26.2, C27.2, C28.2, C29.2, C30.2, C31.2, C32.2, C33.2, C34.2, C35.2, C38.2, C39.2, C40.2, C41.2, C42.2, D1.1 (K), D3.1 (K), D6.1 (K), D7.1 (K), D8.1 (K), D9.1 (K), D10.1 (K), D11.1 (K), D12.1 (K), D13.1 (K), ESP1.1 (GND), ESP1.2 (GND), ESP1.42 (GND), ESP1.43 (GND), ESP1.46 (GND), ESP1.47 (GND), ESP1.48 (GND), ESP1.49 (GND), ESP1.50 (GND), ESP1.51 (GND), ESP1.52 (GND), ESP1.53 (GND), ESP1.54 (GND), ESP1.55 (GND), ESP1.56 (GND), ESP1.57 (GND), ESP1.58 (GND), ESP1.59 (GND), ESP1.60 (GND), ESP1.61 (GND), ESP1.62 (GND), ESP1.63 (GND), ESP1.64 (GND), ESP1.65 (GND), ESP1.66 (GND), ESP1.67 (GND), ESP1.68 (GND), ESP1.69 (GND), ESP1.70 (GND), ESP1.71 (GND), ESP1.72 (GND), ESP1.73 (GND), HSE1.2, HSE1.4, I2C-ESP1.1, I2C-STM1.1, J1.N, LED1.1 (K), LED2.1 (K), PWM1.03, PWM1.06, PWM1.09, PWM1.12, PWM1.15, PWM1.18, PWM1.21, PWM1.24, Q1.3 (E), Q2.1 (S), Q2.2 (S), Q2.3 (S), Q3.1 (S), Q3.2 (S), Q3.3 (S), Q4.1 (S), Q4.2 (S), Q4.3 (S), Q5.1 (S), Q5.2 (S), Q5.3 (S), R1.1, R6.1, R7.2, R20.1, R21.2, R31.2, R44.2, R46.2, R47.2, RFM1.1 (GND), RFM1.8 (GND), RFM1.10 (GND), RGB1.3 (VSS), RGB2.3 (VSS), RN1.5 (R4.2), RN1.6 (R3.2), RN1.7 (R2.2), RN1.8 (R1.2), RN2.1 (R1.1), RN2.2 (R2.1), RN2.3 (R3.1), RN2.4 (R4.1), RST-BOOT-ESP1.4, RST-BOOT-STM1.4, S1.1, S2.2, S3.1, S4.1, SD1.6 (VSS), SD1.9 (SHIELD), SD1.10 (SHIELD), SD1.11 (SHIELD), SD1.12 (SHIELD), STM1.12 (VSSA), STM1.18 (VSS), STM1.63 (VSS), SWD1.3, SWD1.5, SWD1.7, SWD1.9, U1.2 (GND), U2.2 (GND), U3.1 (GND), U3.4 (GND), U3.5 (GND), U3.6 (GND), U3.10 (GND), U3.11 (GND), U3.15 (GND), U3.16 (GND), U3.20 (GND), U4.1 (GND), U4.7 (GND), U5.5 (GND), U5.10 (GND), U5.12 (GND), U5.13 (GND), U5.16 (GND), U6.6 (GND), U6.7 (GND), U7.2 (A1), U7.3 (A2), U7.4 (A3), U7.5 (A4), U7.14 (VSS), U7.24 (A5), U7.25 (EXTCLK), U8.3 (GND), U9.4 (VSS), U10.1 (GND), U11.1 (GND), U12.6 (GND), UART1-RFD-ESP1.1, UART1-RFD-STM1.1, UART2-STM1.1, USB1.A1 (GND), USB1.A12 (GND), USB1.B1 (GND), USB1.B12 (GND), USB2.A1 (GND), USB2.A12 (GND), USB2.B1 (GND), USB2.B12 (GND), W25Q1.4 (GND)
GPS_INT: RFM3.4, U3.19 (EXTINT)
GPS_RST: RFM3.3, U3.18 (~RESET)
GPS_RX: R24.2, RFM3.1
GPS_SAFE: RFM3.5, U3.8 (~SAFEBOOT)
GPS_SCL: R40.1, STM1.58 (PB6), U3.12 (SCL), U7.26 (SCL), U8.8 (SCL), U9.2 (SCL), U12.4 (SCL)
GPS_SDA: R39.1, STM1.59 (PB7), U3.9 (SDA), U7.27 (SDA), U8.7 (SDA), U9.1 (SDA), U12.3 (SDA)
GPS_TX: R23.1, RFM3.2
GPS_VBCKP: BT1.1 (+), C23.1, R27.1, U3.3 (V_BCKP)
H3LIS331DL_CS: R26.2, STM1.37 (PC6), U5.8 (CS)
I2C-1_STM32: ESP1.41 (IO45), R53.2
INA219_IN+: J1.P, R50.1, U12.8 (IN+)
INA219_IN-: Q6.1 (C), R50.2, U12.7 (IN-)
LSM6DSO32TR_CS: R28.2, STM1.25 (PC5), U6.12 (CS)
unnamed: C10.1, HSE1.3, R3.2
unnamed: D1.2 (A), R4.1
unnamed: D2.2 (A), R13.1
unnamed: D3.2 (A), R25.1
unnamed: D4.1 (K), R27.2
unnamed: D6.2 (A), R53.1
unnamed: D7.2 (A), R54.1
unnamed: D8.2 (A), R55.1
unnamed: D9.2 (A), R56.1
unnamed: D10.2 (A), R57.1
unnamed: D11.2 (A), R58.1
unnamed: D12.2 (A), R59.1
unnamed: D13.2 (A), R60.1
unnamed: LED1.2 (A), R51.2
unnamed: LED2.2 (A), R52.2
unnamed: Q1.2 (B), R2.1
unnamed: BZ1.2, Q1.1 (C)
unnamed: Q2.4 (G), R8.1, RN1.1 (R1.1)
unnamed: Q3.4 (G), R9.1, RN1.2 (R2.1)
unnamed: Q4.4 (G), R10.1, RN1.3 (R3.1)
unnamed: Q5.4 (G), R11.1, RN1.4 (R4.1)
unnamed: R5.2, S1.2
unnamed: R1.2, STM1.28 (PB2)
unnamed: C1.1, STM1.31 (VCAP_1)
unnamed: C3.1, STM1.47 (VCAP_2)
unnamed: R24.1, U3.14 (RXD)
unnamed: R23.2, U3.13 (TXD)
unnamed: R32.1, U7.1 (A0)
unnamed: R31.1, U7.23 (~OE)
unnamed: R41.2, U10.5 (EN)
unnamed: C36.2, L1.1, U10.2 (SW)
unnamed: C36.1, U10.6 (VBST)
unnamed: R43.2, R44.1, U10.4 (VFB)
unnamed: R42.2, U11.5 (EN)
unnamed: C37.2, L2.1, U11.2 (SW)
unnamed: C37.1, U11.6 (VBST)
unnamed: R45.2, R46.1, U11.4 (VFB)
unnamed: R49.1, U12.2 (A0)
unnamed: R48.1, U12.1 (A1)
unnamed: R6.2, USB1.A5 (CC1)
unnamed: R7.1, USB1.B5 (CC2)
unnamed: R20.2, USB2.A5 (CC1)
unnamed: R21.1, USB2.B5 (CC2)
PULSE: R25.2, U3.7 (TIMEPULSE)
PWM0: PWM1.01, U7.13 (LED7)
PWM1: PWM1.04, U7.12 (LED6)
PWM2: PWM1.07, U7.11 (LED5)
PWM3: PWM1.10, U7.10 (LED4)
PWM4: PWM1.13, U7.9 (LED3)
PWM5: PWM1.16, U7.8 (LED2)
PWM6: PWM1.19, U7.7 (LED1)
PWM7: PWM1.22, U7.6 (LED0)
PYRO-TERM_A: J2.1, Q5.5-8, RN3.8 (R1.2)
PYRO-TERM_B: J2.2, Q4.5-8, RN3.7 (R2.2)
PYRO-TERM_C: J2.3, Q3.5-8, RN3.6 (R3.2)
PYRO-TERM_D: J2.4, Q2.5-8, RN3.5 (R4.2)
PYRO_A: R11.2, STM1.62 (PB9)
PYRO_B: R10.2, STM1.61 (PB8)
PYRO_C: R9.2, STM1.54 (PD2)
PYRO_D: R8.2, STM1.53 (PC12)
RFD_900: ESP1.37 (IO41), R57.2
RFM95W_ANT: ANT1.1, RFM1.9 (ANT)
RFM95W_DI0: ESP1.18 (IO14), RFM1.14 (DIO0)
RFM95W_DI1: RFM1.15 (DIO1), RFM2.5
RFM95W_DI2: RFM1.16 (DIO2), RFM2.4
RFM95W_DI3: RFM1.11 (DIO3), RFM2.3
RFM95W_DI4: RFM1.12 (DIO4), RFM2.2
RFM95W_DI5: RFM1.7 (DIO5), RFM2.1
RFM95W_RST: ESP1.13 (IO9), RFM1.6 (RESET)
SD_CS: SD1.2 (CD/DAT3), STM1.38 (PC7)
SPI-1_ESP32: ESP1.38 (IO42), R56.2
SPI-1_STM32: ESP1.39 (TXD0), R55.2
SPI-2_STM32: ESP1.40 (RXD0), R54.2
STM32-BOOT0: R4.2, R5.1, RST-BOOT-STM1.1, STM1.60 (BOOT0)
STM32-HSE_IN: C8.2, HSE1.1, STM1.5 (PH0)
STM32-HSE_OUT: R3.1, STM1.6 (PH1)
STM32-I2C2_SCL: I2C-STM1.4, R36.1, STM1.29 (PB10)
STM32-I2C2_SDA: I2C-STM1.3, R35.1, STM1.30 (PB11)
STM32-NRST: C12.1, RST-BOOT-STM1.3, S4.2, STM1.7 (NRST), SWD1.10
STM32-RGB_IN: RGB1.4 (DIN), STM1.2 (PC13)
STM32-SWCLK: STM1.49 (PA14), SWD1.4
STM32-SWDIO: STM1.46 (PA13), SWD1.2
STM32-UART1_RX: STM1.43 (PA10), UART1-RFD-STM1.3
STM32-UART1_TX: STM1.42 (PA9), UART1-RFD-STM1.4
STM32-UART2_RX: STM1.17 (PA3), UART2-STM1.3
STM32-UART2_TX: STM1.16 (PA2), UART2-STM1.4
STM32-UART3_RX: R18.1, STM1.52 (PC11)
STM32-UART3_TX: R19.1, STM1.51 (PC10)
STM32_USB_D+: STM1.45 (PA12), U1.4 (I/O2)
STM32_USB_D-: STM1.44 (PA11), U1.6 (I/O1)
USB1_D+: U1.3 (I/O2), USB1.A6 (D+), USB1.B6 (D+)
USB1_D-: U1.1 (I/O1), USB1.A7 (D-), USB1.B7 (D-)
USB2_D+: U2.3 (I/O2), USB2.A6 (D+), USB2.B6 (D+)
USB2_D-: U2.1 (I/O1), USB2.A7 (D-), USB2.B7 (D-)
V-TERM_A: RN2.8 (R1.2), RN3.1 (R1.1), STM1.8 (PC0)
V-TERM_B: RN2.7 (R2.2), RN3.2 (R2.1), STM1.9 (PC1)
V-TERM_C: RN2.6 (R3.2), RN3.3 (R3.1), STM1.10 (PC2)
V-TERM_D: RN2.5 (R4.2), RN3.4 (R4.1), STM1.11 (PC3)
VBUS: D5.A, Q6.2 (B), R47.1, U1.5 (VBUS), U2.5 (VBUS), USB1.A4 (VBUS), USB1.A9 (VBUS), USB1.B4 (VBUS), USB1.B9 (VBUS), USB2.A4 (VBUS), USB2.A9 (VBUS), USB2.B4 (VBUS), USB2.B9 (VBUS)
VIN: C32.1, C33.1, C34.1, C35.1, D5.C, Q6.3 (E), R41.1, R42.1, U10.3 (VIN), U11.3 (VIN)
