nasheed-x/aether/(commit log)

2023-07-17 initial file upload
    [aether.kicad_pcb, aether.kicad_sch]
2023-08-02 Added Power & USB
    [aether.kicad_sch]
2023-08-03 Added IMUs and Barometers
    [aether.kicad_sch]
2023-08-09 Added ESP32 + Modified Symbols
    [aether.kicad_pcb, aether.kicad_sch]
2023-08-11 added hierarchal sheets
    [aether.kicad_sch, connectors.kicad_sch, esp32.kicad_sch, power.kicad_sch, sensors.kicad_sch, shared_mcu_buses.kicad_sch]
2023-08-11 Organized Schematics & Fixed Notes
    [aether.kicad_sch, connectors.kicad_sch, esp32.kicad_sch, power.kicad_sch, sensors.kicad_sch, shared_mcu_buses.kicad_sch]
2023-08-11 deleted files
    [aether.kicad_sch, shared_mcu_buses.kicad_sch]
2023-08-11 Added OSH Logo
    [aether.kicad_sch, connectors.kicad_sch, esp32.kicad_sch, power.kicad_sch, sensors.kicad_sch]
2023-08-12 Updated files
    [aether.kicad_sch, connectors.kicad_sch, esp32.kicad_sch, power.kicad_sch, sensors.kicad_sch]
2023-09-20 Added INA219
    [aether.kicad_sch, connectors.kicad_sch, esp32.kicad_sch, power.kicad_sch, sensors.kicad_sch]
2023-09-28 Added connectors
    [aether.kicad_sch, connectors.kicad_sch, esp32.kicad_sch, power.kicad_sch, sensors.kicad_sch]
2023-10-26 updated footprint library
    [aether.kicad_sch, connectors.kicad_sch, esp32.kicad_sch, power.kicad_sch, sensors.kicad_sch]
2023-10-28 Updated symbol footprints
    [aether.kicad_sch, connectors.kicad_sch, esp32.kicad_sch, power.kicad_sch, sensors.kicad_sch]
2023-12-02 updated schematic
    [aether.kicad_pcb, aether.kicad_sch, connectors.kicad_sch, esp32.kicad_sch, power.kicad_sch, sensors.kicad_sch]
2023-12-02 updated pcb
    [aether.kicad_pcb, aether.kicad_sch, power.kicad_sch, sensors.kicad_sch]
2023-12-03 grouped components
    [aether.kicad_pcb, connectors.kicad_sch, power.kicad_sch]
2023-12-31 updated tracks
    [aether.kicad_pcb, connectors.kicad_sch, sensors.kicad_sch]
2024-03-03 started routing
    [aether.kicad_pcb, connectors.kicad_sch, power.kicad_sch, sensors.kicad_sch]
2024-03-07 more routing
    [aether.kicad_pcb]
2024-05-22 significant amount of routing done
    [aether-rev2.kicad_pcb, aether.kicad_sch, connectors.kicad_sch, esp32.kicad_sch, power.kicad_sch, sensors.kicad_sch]
2024-05-24 signals routed
    [aether-rev2.kicad_pcb, aether.kicad_pcb, aether.kicad_sch, connectors.kicad_sch, esp32.kicad_sch]
2024-05-24 updated read me
    [aether.kicad_pcb]
2024-05-24 updated schematics
    [aether.kicad_pcb, esp32.kicad_sch]
2024-05-27 added power planes
    [aether.kicad_pcb, aether.kicad_sch, connectors.kicad_sch, esp32.kicad_sch, power.kicad_sch, sensors.kicad_sch]
2024-05-29 moved pcb files to hardware folder
    [aether.kicad_sch, connectors.kicad_sch, esp32.kicad_sch, power.kicad_sch, sensors.kicad_sch]
2024-05-29 Reorganizing directory
    [aether.kicad_sch, connectors.kicad_sch, esp32.kicad_sch, power.kicad_sch, sensors.kicad_sch]
2024-05-29 create hardware folder
    [aether.kicad_sch, connectors.kicad_sch, esp32.kicad_sch, power.kicad_sch, sensors.kicad_sch]
2025-02-03 added BNO086
    [5-1814832-1.step, ML414H_IV01E.step, aether.kicad_sch, connectors.kicad_sch, esp32.kicad_sch, power.kicad_sch, sensors-2.kicad_sch, sensors.kicad_sch]
2025-03-31 rev2 component placement
    [3D_PCB1_2025-03-28 parts - DFN-8_L5.0-W3.0-P1.25-BL-BR~DFN-8_L5.0-W3.0-P1.25-BL-BR~tLj9.step, CSS-0575B-SMT.step, DPS310.step, ESP32-S3-MINI-1U-N8.step, POWERPAK-CHIPFET-8_L3.0-W1.9-P0.65.step, SHT45-AD1B-R2.step, TSW-108-08-T-T-RA.step, aether.kicad_pcb]
2025-07-07 rev2 routed
    [aether.kicad_pcb, aether_2023.kicad_pcb]
2025-07-12 updated routing
    [aether.kicad_pcb, esp32.kicad_sch]
