nasheed-x/aether/(notices)

Notices in the files:
hardware/symbols/TSW-108-08-T-T-RA/TSW-108-08-T-T-RA.step:
author */ ('License CC BY-ND 4.0'),
